nathanchiu05/digital_spirometer/cad/spirometer-base-assem-final.STL

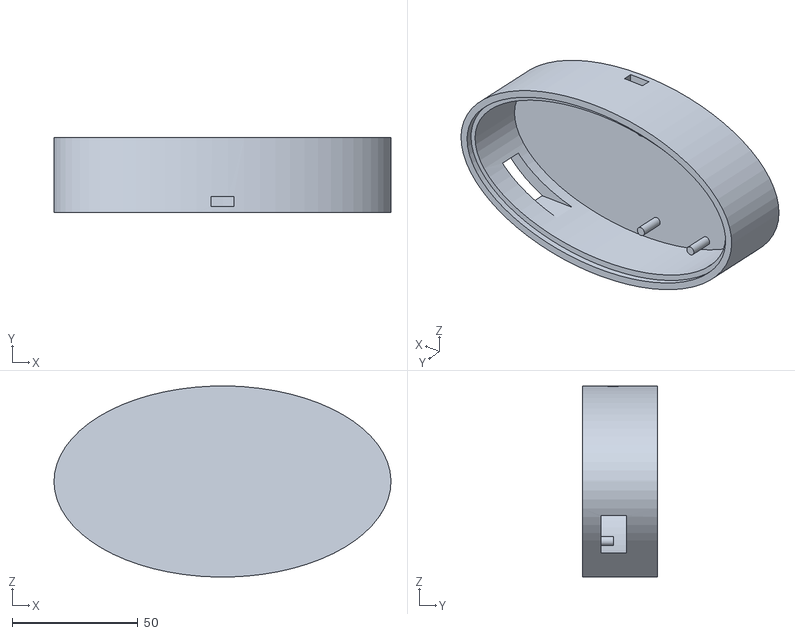
[picture p1: CAD file, 2026-10-15]
cad/spirometer-base-assem-final.STL
134.0 x 30.0 x 75.9
