nathanchiu05/digital_spirometer/(commit log)

2026-10-07 reworked hardware setup, GPIO setup, calibrations, UI tweaks
    [SmartSpirometer.ino, ToFTest.ino]
2026-10-15 diagrams and sample stats
2026-10-15 circuit diagram + limitations clarification
2026-10-15 circuit img path corrected
2026-10-16 update charts with 750mL threshold instead of 500mL
